creare-com/dms_docs/README.md

# dms_docs
DMS specifications and documentation, published for external collaborators.
