creare-com/dms_docs/_images/BioTek_Triggers.png

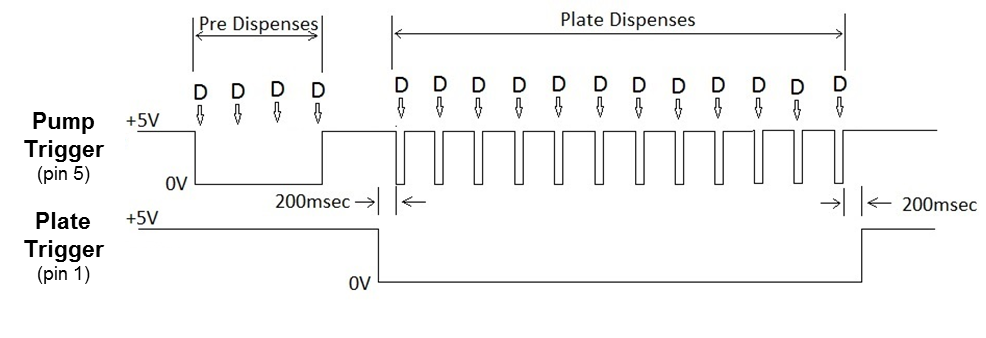
_images/BioTek_Triggers.png
