creare-com/dms_docs/_images/fault_detection_schematic.png

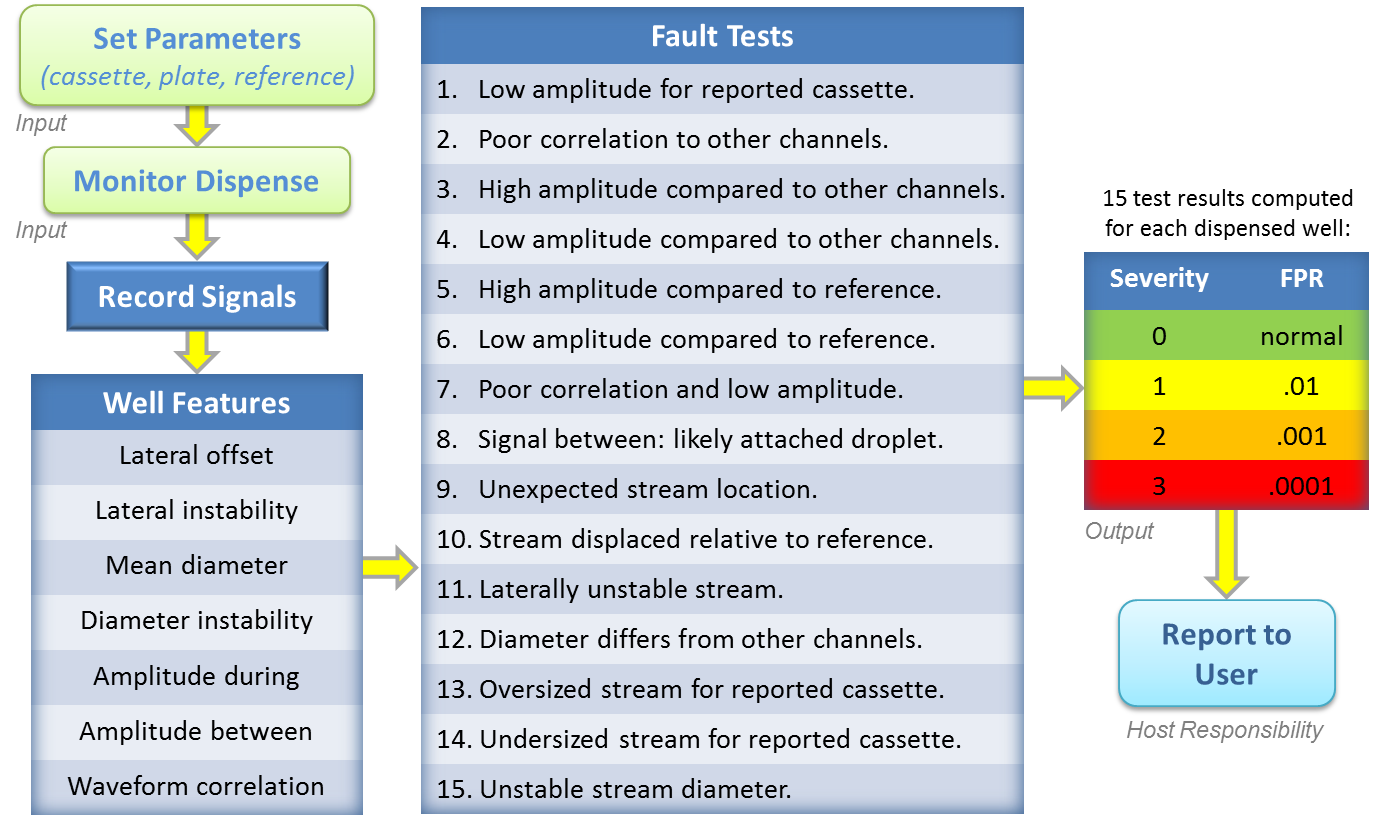
_images/fault_detection_schematic.png
