creare-com/dms_docs/_images/feature_cdf_pre-BioTek_MCR_tmp.png

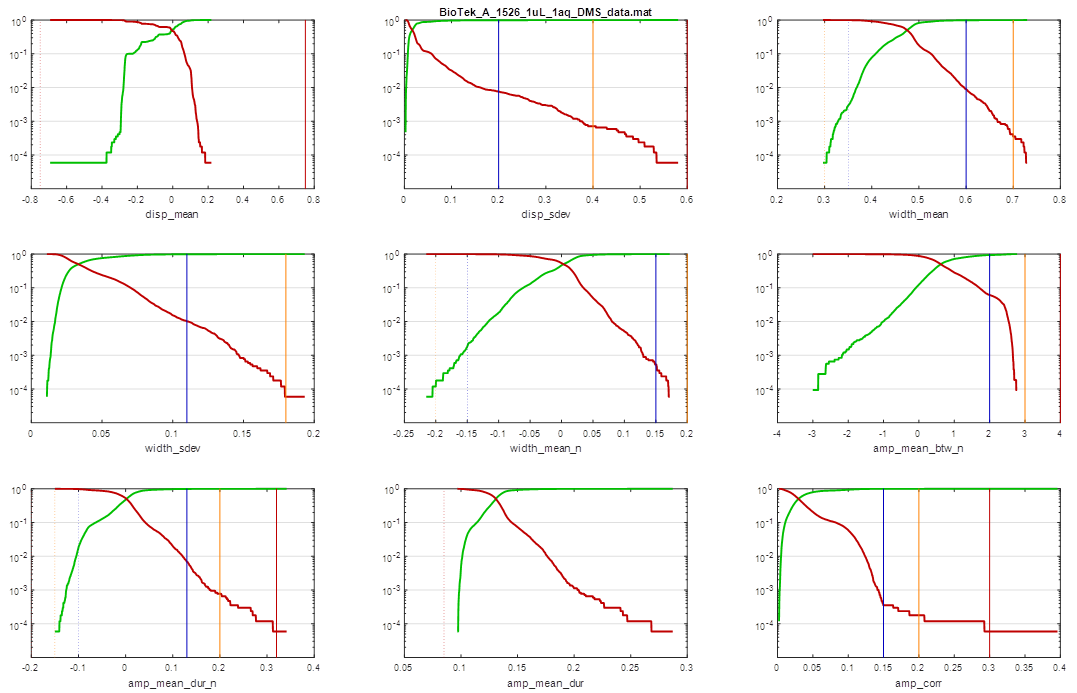
_images/feature_cdf_pre-BioTek_MCR_tmp.png
