creare-com/dms_docs/_images/feature_dist_original_training.png

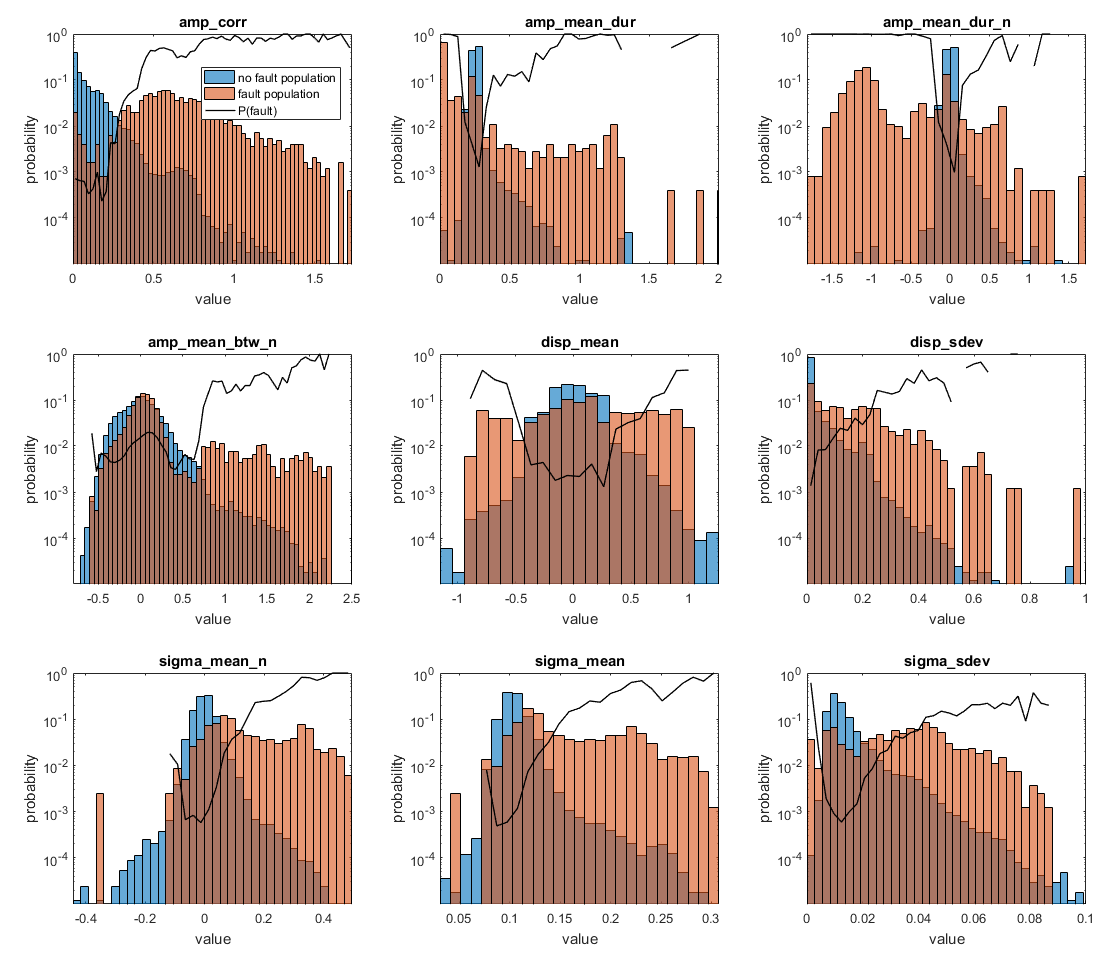
_images/feature_dist_original_training.png
