creare-com/dms_docs/_images/Mapping_of_Stream_Data_Bytes_to_Pixels.png

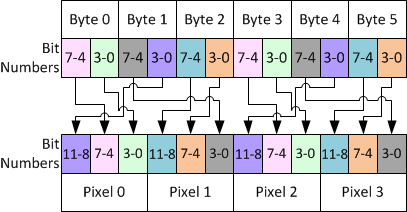
_images/Mapping_of_Stream_Data_Bytes_to_Pixels.png
