creare-com/dms_docs/_images/precision_recall_original.png

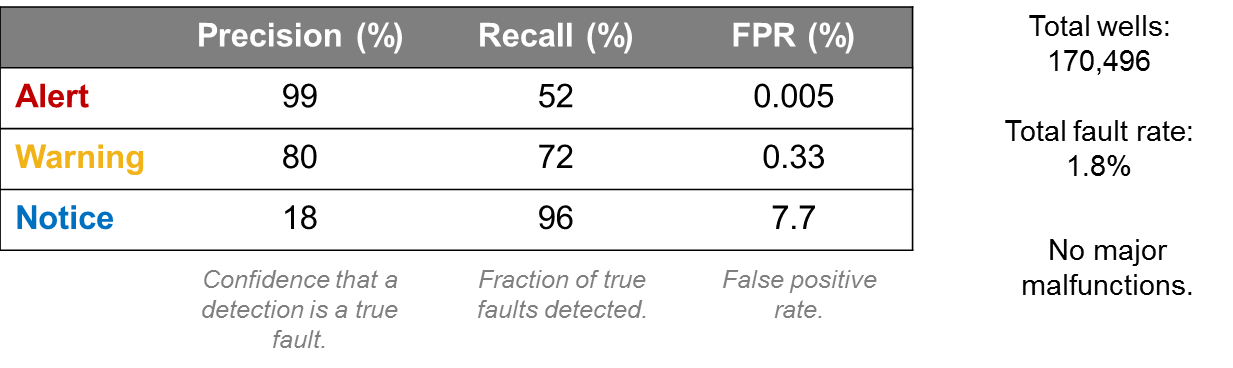
_images/precision_recall_original.png
