creare-com/dms_docs/_static/Creare_DMS.png

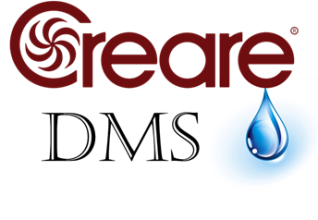
_static/Creare_DMS.png
