creare-com/dms_docs/_downloads/7819-030-0700_rH Optics Housing Cover.stp

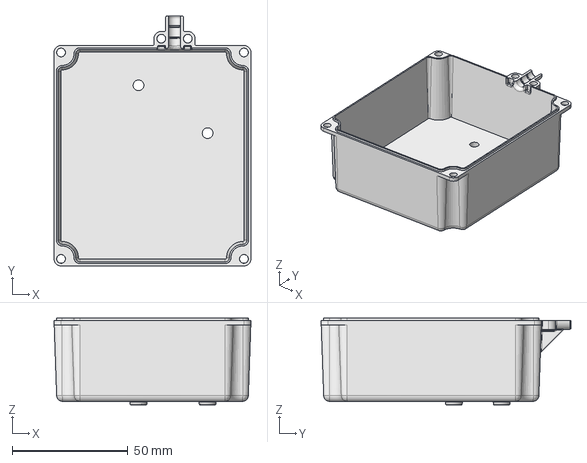
[picture p8: CAD file, 2018-09-05, last stored version]
_downloads/7819-030-0700_rH Optics Housing Cover.stp
85.1 x 107.9 x 37.5 mm
