creare-com/dms_docs/_downloads/7819-030-0600_rK Optics Housing Base.stp

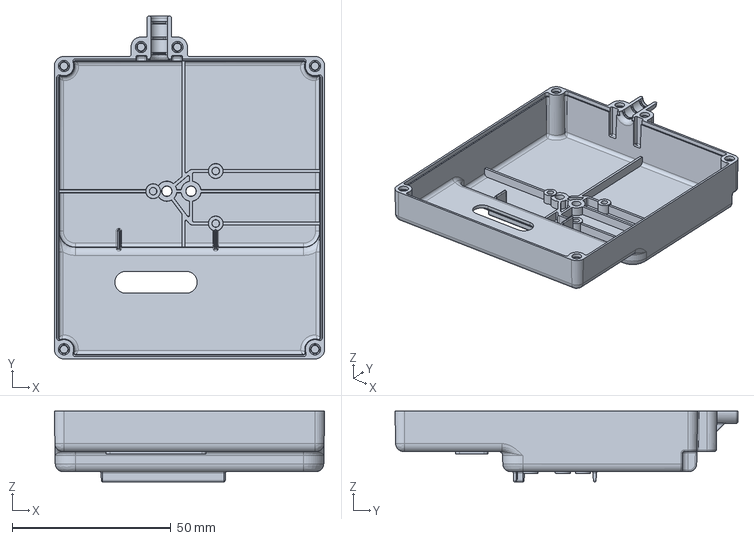
[picture p9: CAD file, 2018-09-05, last stored version]
_downloads/7819-030-0600_rK Optics Housing Base.stp
85.1 x 107.9 x 22.2 mm
