creare-com/dms_docs/_downloads/7819-030-0500_rA Sensor Housing.stp

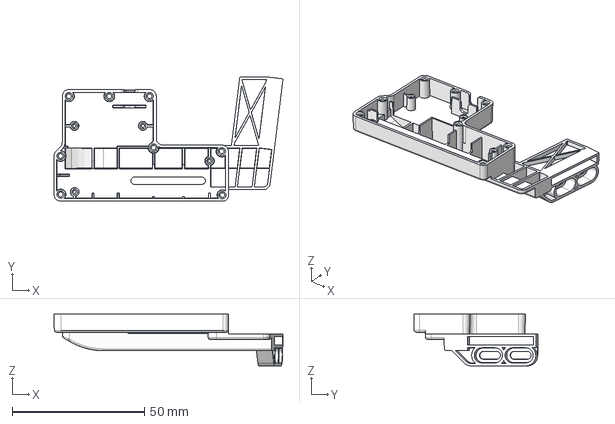
[picture p10: CAD file, 2018-09-05, last stored version]
_downloads/7819-030-0500_rA Sensor Housing.stp
86.5 x 46.9 x 19.6 mm
