creare-com/dms_docs/_downloads/7819-030-0400_rO Optics Spine.stp

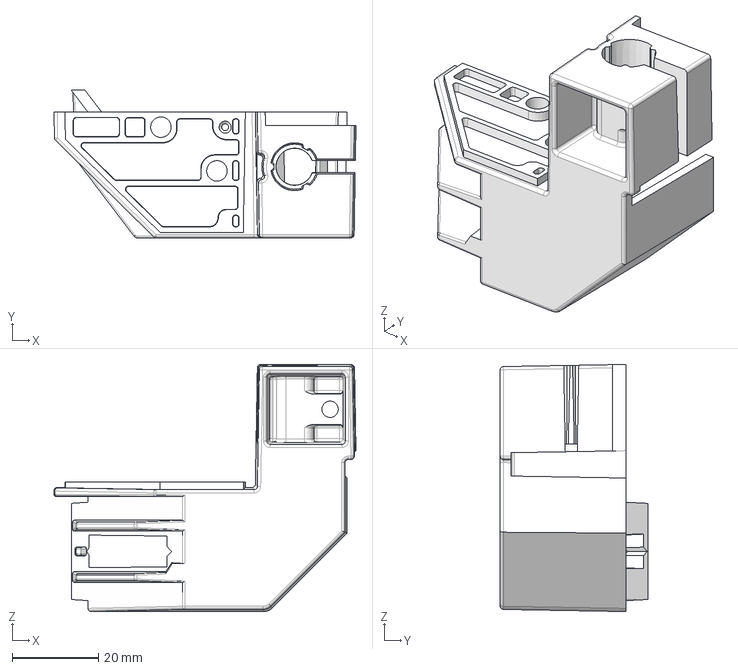
[picture p11: CAD file, 2018-09-05, last stored version]
_downloads/7819-030-0400_rO Optics Spine.stp
70.1 x 34.3 x 57.4 mm
