creare-com/dms_docs/_downloads/7819-030-0550_rA Sensor Housing Cover.stp

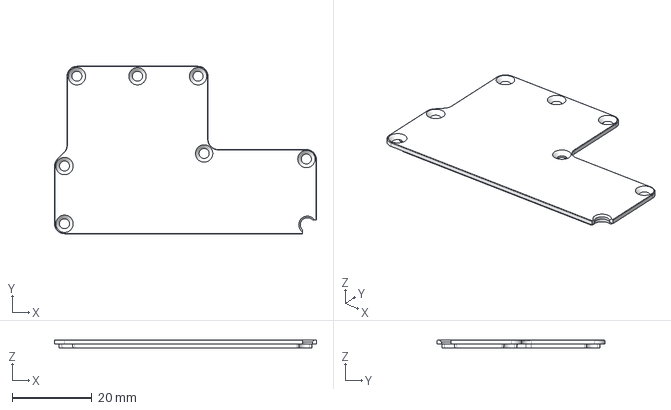
[picture p12: CAD file, 2018-09-05, last stored version]
_downloads/7819-030-0550_rA Sensor Housing Cover.stp
65.9 x 42.1 x 2.08 mm
