creare-com/dms_docs/(commit log)

2018-01-09 Automated document build by publish.bat.
    [7819 DMS Master BOM.xls]
2018-02-07 Automated document build by publish_summit.bat.
    [7819 DMS Master BOM.xls]
